jamesgrogantech/nuaire-mrxbox-eco2/hardware/case/preview.png

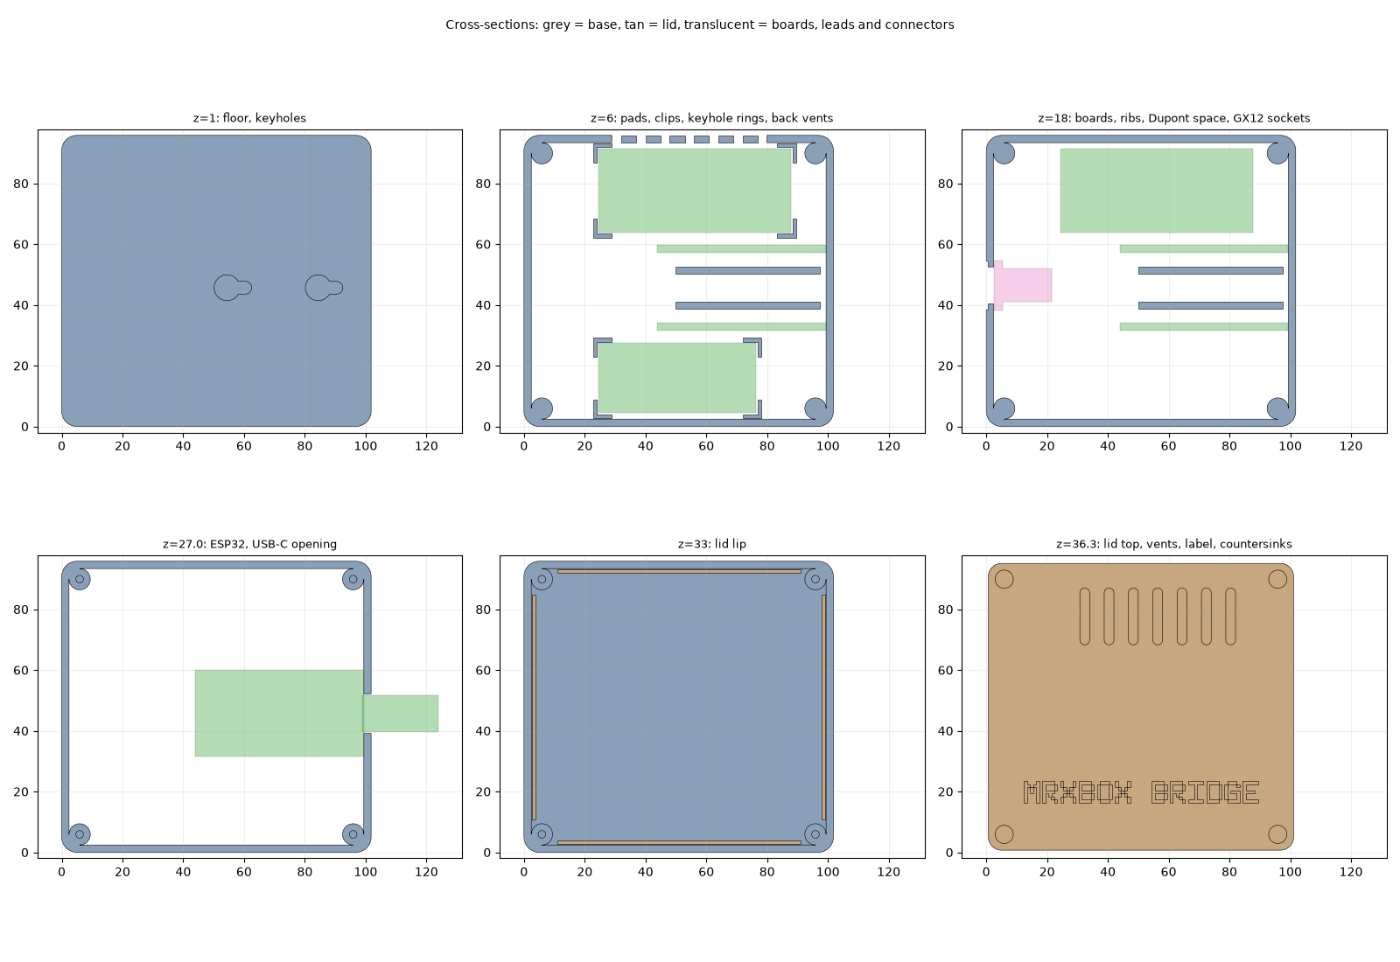
hardware/case/preview.png
