jamesgrogantech/nuaire-mrxbox-eco2/hardware/case/renders/1-closed.png

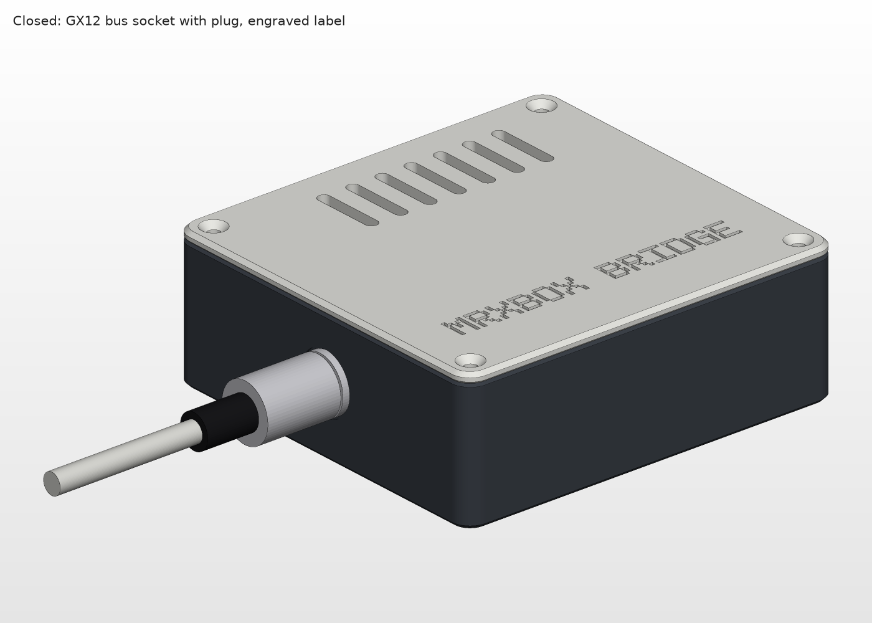
hardware/case/renders/1-closed.png
