jamesgrogantech/nuaire-mrxbox-eco2/hardware/case/renders/3-open.png

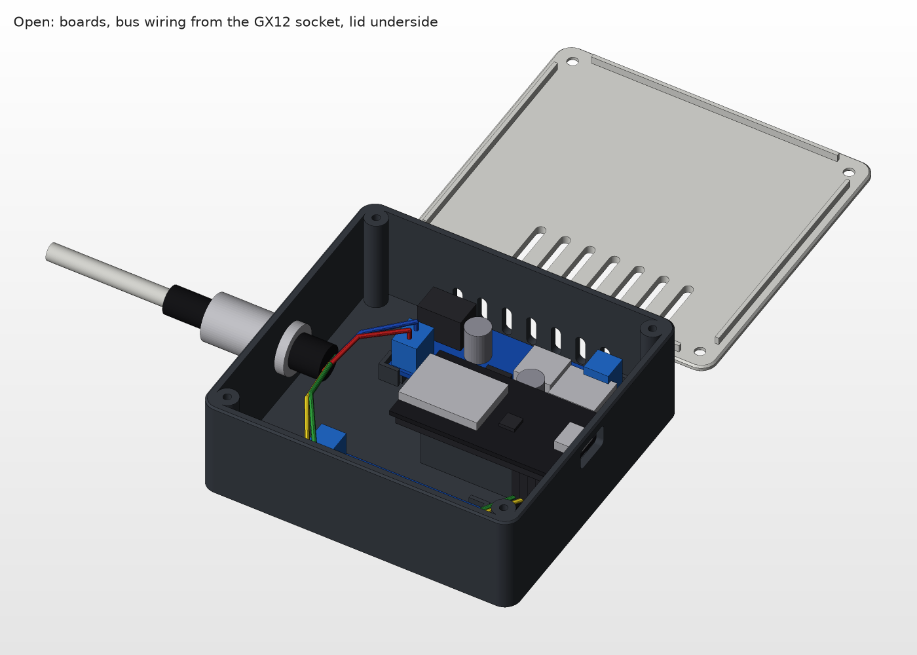
hardware/case/renders/3-open.png
