jamesgrogantech/nuaire-mrxbox-eco2/hardware/case/renders/5-bottom.png

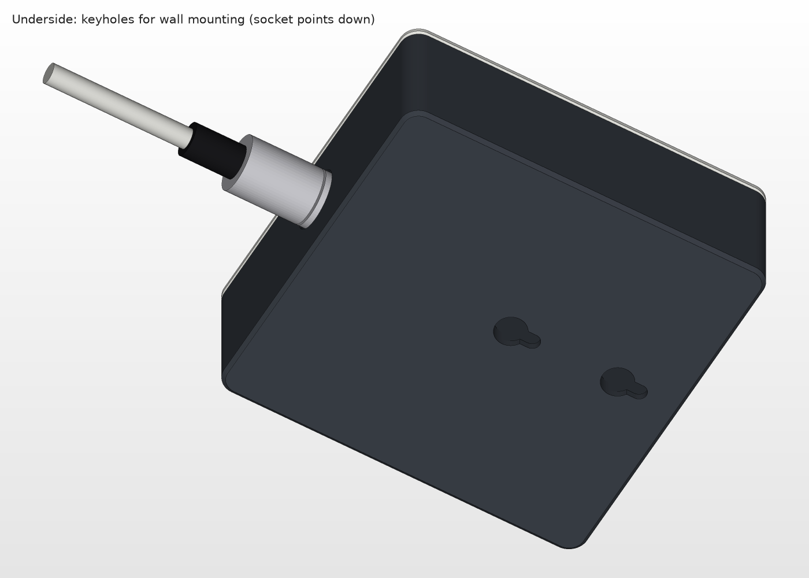
hardware/case/renders/5-bottom.png
