jamesgrogantech/nuaire-mrxbox-eco2/hardware/case/renders/6-sockets.png

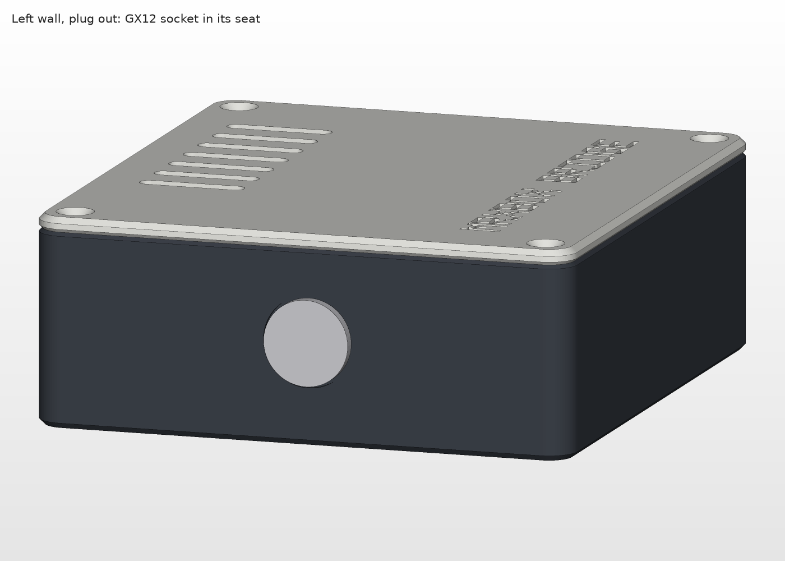
hardware/case/renders/6-sockets.png
