jamesgrogantech/nuaire-mrxbox-eco2/hardware/case/base.stl

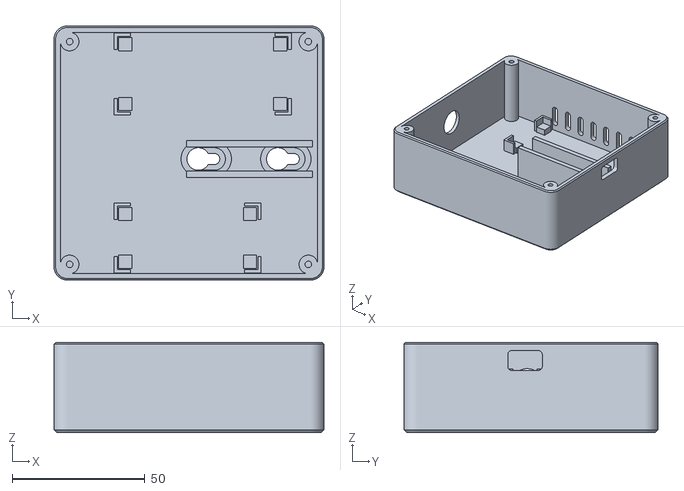
[picture p6: CAD file, 2026-11-08]
hardware/case/base.stl
101.8 x 95.8 x 34.0
