jamesgrogantech/nuaire-mrxbox-eco2/docs/wiring-deploy.html

Nuaire MRXBOX ECO2 · Home Assistant · read-only deploy

# MRXBOX HA Deploy Wiring

Permanent install: powered from the unit's own 12 V via a buck converter, reading the bus at 1200 baud over WiFi to Home Assistant. No laptop, no USB.

Set the buck output to 5.0 V with a meter BEFORE wiring it to the Pico. Trim-pot bucks ship at random voltages; VSYS tolerates max 5.5 V, and 12 V straight in destroys the Pico.

One 4-pin connector powers and feeds the Pico: 12 V through the buck (set to 5 V) into VSYS, A/B into the MAX485 whose RO drives GP5. Everything shares one ground. DE+RE tied low = physically receive-only. The Pico reads at 1200 8N1 and publishes over WiFi — no USB in service.

## Connections

Wire | From | To | Note
12V | MVHR 12V pin | Buck IN+ | The pin we kept capped until now
5V | Buck OUT+ | Pico VSYS (pin 39) | ⚠️ set buck to 5.0V first; add a Schottky in series if USB may also be plugged in
GND | MVHR GND | Buck IN−/OUT−, MAX485 GND, Pico GND (pin 38) | One common ground for everything
A | MVHR A | MAX485 A | If no data: swap A/B (dongle needed the opposite order)
B | MVHR B | MAX485 B
Data | MAX485 RO | Pico GP5 (pin 7) | UART1 RX, 1200 8N1
3V3 | Pico 3V3 OUT (pin 36) | MAX485 VCC | ⚠️ pin 36, never pin 37 (3V3_EN)
Jumper | MAX485 DE+/RE | GND | Receive-only — cannot transmit
— | MAX485 DI | nothing | Unused (read-only)

## Bring-up order

- Set the buck to 5.0 V on the bench (12V or any source in, meter on the output, turn the trim-pot) before anything connects to the Pico.
- Wire grounds first, then A/B to the MAX485, then RO/3V3, then last the buck 5 V to VSYS.
- Power the unit; the Pico boots, joins WiFi, reads the bus. No USB needed — but you can still plug USB for firmware updates (that's why the Schottky matters if both power sources meet).
- If the MAX485 module has a 120 Ω terminator and reception looks noisy on an already-terminated bus, lift it.

Read-only by design — DE+RE grounded means the Pico physically cannot drive the bus. Firmware reads 1200 8N1 on GP5, bit-reverses data bytes, and publishes humidity / temperature / fan state to Home Assistant. Companion to the bench diagram in docs/wiring.html and the field map in docs/protocol.md.
