jamesgrogantech/nuaire-mrxbox-eco2/docs/wiring.html

Nuaire MRXBOX ECO2 · Phase 1 · receive-only

# MRXBOX Sniffer Wiring

Pico W + RS485 module tapped onto the MVHR display connector for bus sniffing. Five wires now, one dashed option for later.

Two rules before anything touches the unit: run the RS485 module at 3.3 V (RP2040 pins are not 5 V-tolerant), and identify all four MVHR pins with the meter before connecting a single wire — the 12 V pin stays unconnected in this phase.

Receive-only tap: the RS485 pair lands on the module's A/B, the module's RO feeds the Pico's UART1 RX on GP5, and DE + R̄Ē tied to ground keep the driver permanently off so nothing can transmit onto the bus. Solid wires are this build; the dashed 12 V → buck → VSYS run is the later self-powered option.

## Connections

Wire | From | To | Note
A | MVHR pin (idles higher) | Module A | Confirm with meter: higher idle voltage of the two data lines
B | MVHR pin (idles lower) | Module B | If first captures are garbage at every baud, swap A/B
GND | MVHR 0 V pin | Module GND + Pico pin 38 | One common ground — the only connection shared with the unit besides A/B
Data | Module RO | Pico GP5 (pin 7) | UART1 RX — matches RX_PIN = 5 in the sniffer firmware
Power | Pico 3V3 (pin 36) | Module VCC | 3.3 V only. A 5 V-fed module puts ~5 V on RO and can kill the RP2040 pin
Jumper | Module DE + R̄Ē | Module GND | Driver off, receiver on — the tap physically cannot transmit
— | Module DI | nothing | Unused until the write-back phase
12 V | MVHR 12 V pin | nothing (later: buck → VSYS pin 39) | Cap it off for now. Never to VSYS directly — 5.5 V max

## Identifying the four MVHR pins

Pin | Meter signature (DC to GND)
GND | 0 V, rock steady. Find first: probe pin pairs until one reads a steady 12 V — the lower pin of that pair is GND
12 V | Steady ~12 V, no flicker
A | Idle ~1.5–3.3 V, the higher of the two data lines; flickers with traffic
B | Idle lower than A (often 0.5–1.5 V); flickers with traffic

- Getting GND right matters most — tying the unit's 12 V rail to Pico ground shorts it through USB and can damage the unit's PSU.
- Both data lines steady at ~0 V usually means the bus is just quiet — wait 30 s+, sensors poll infrequently.
- Cheap modules often carry a 120 Ω termination resistor. If reception looks corrupted on a bus that already has termination, remove it. Keep the tap stub under ~30 cm.

Companion to docs/hardware.md in the nuaire repo — that file holds the safety procedure (isolate the unit before opening) and the full pin-identification walkthrough. Firmware expects GP5 / UART1 RX; capture with nc <pico-ip> 9000.
