jamesgrogantech/nuaire-mrxbox-eco2/(commit log)

2026-09-13 Reverse-engineer Nuaire MRXBOX ECO2 bus; read-only Home Assistant integration
    Decoded the MVHR's display-connector bus from scratch and built a Pico W +
    MAX485 bridge that publishes to Home Assistant over MQTT.
    Protocol (docs/protocol.md):
    - RS485, 1200 baud 8N1, data bytes MSB-first (bit-reversed vs UART)
    - ~0.7s broadcast of 9 gap-separated messages
    - Humidity: msg 3B byte1 bit-reversed -> RH% (stimulus-confirmed)
    - Fan/boost: msg 21 byte2 bit 0x02 (stimulus-confirmed)
    - Temperature: candidate values constant + unresponsive to stimulus -> not a
    real reading; retracted
    Firmware:
    - firmware/ha/ha_read.py: read @1200 8N1 on GP5, publish humidity+boost with
    HA MQTT auto-disco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
    [analyze.py, baudfind.py, bittiming.py, capture_frame.py, decode1200.py, diff_frames.py, ha_read.py, main.py]
2026-09-13 Add long-term frame-byte logging (both HA-native and CSV) to decode more fields
    Firmware: publish all 16 candidate frame bytes (bit-reversed) as one
    nuaire/raw CSV topic every 15s, alongside the existing humidity/boost. Built
    via an additive gap-split assembler; the anchored humidity/boost decode is
    unchanged.
    Method A (HA-native): docs/ha-diagnostics.yaml - 16 diagnostic MQTT template
    sensors parsing nuaire/raw; correlate in HA History vs Met.no outdoor temp.
    Method B (offline): tools/log_raw.sh (mosquitto_sub -> timestamped CSV) and
    tools/analyze_longterm.py (stdlib; per-byte variance/trend + correlation with
    time-of-day and open-meteo outdoor temp).
    docs/longterm-logging.md documents t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
    [analyze_longterm.py, ha_read.py]
2026-09-13 firmware: self-heal CYW43 zombie WiFi; HA-native raw logging via MQTT discovery
    Pico bridge was dying every 2-6 min and staying dead until manual repower.
    Root cause: the CYW43 WiFi stack goes "zombie" - w.isconnected() keeps
    returning True and holds the IP, but no traffic flows and socket sends don't
    raise, so the firmware published into a dead link forever with no exception
    and no reset. A plain watchdog doesn't help (the loop isn't hung, it's fed).
    ha_read.py:
    - Liveness probe: after each publish, c.ping() + c.wait_msg() with a 3s socket
    timeout, requiring a broker PINGRESP round-trip. A zombie/dead link times out
    -> exception -> machine.reset() after 2 consecutive fails (~30s), whic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
    [ha_read.py, publish_raw_discovery.py]
2026-09-14 Prepare for public release: license, contributor docs, secret scrub
    - Add MIT LICENSE (2026 James Grogan)
    - Rewrite README as a public, hardware-agnostic guide with a prominent mains
    safety warning, the confirmed protocol summary, and a "use your own hardware"
    section (Pico W reference; ESP32/ESPHome and USB-RS485 dongle documented)
    - Add CONTRIBUTING.md (receive-only safety, 2-capture confirmation rule,
    capture naming, code conventions, how to report a unit/hardware)
    - Add GitHub unit-report issue template and PR checklist template
    - Scrub the MQTT password and personal LAN IPs from tracked files
    (tools/log_raw.sh now requires args; docs use placeholder IPs)
    - ha_read.py: static IP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
    [ha_read.py, publish_raw_discovery.py, secrets.example.py]
2026-09-15 Document temps as poll-only; add full-frame capture + dumper
    Full-frame capture (every byte of every broadcast message) shows the unit's
    autonomous broadcast is exactly the 9 known messages, with every non-mapped
    byte = 0xFE padding. Combined with 50h of logging (nothing tracks the outdoor
    temperature swing) and the MRXBOX-VSC manual (unit has Extract + Supply temp
    sensors, display shows Outside + Indoor temp), this confirms the temperatures
    are NOT broadcast — the display obtains them by polling the unit. Reading them
    requires MITM-sniffing a real VSC to capture the poll + response.
    - docs/protocol.md: add "Temperatures are POLL-ONLY" (CONFIRMED) and the
    "85 = fan/mode" hypothesis; cor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
2026-09-15 Add VSC MITM guide to capture the polled temperatures
    For anyone who has the MRXBOX-VSC display: the temperatures are polled, not
    broadcast, so a bus capture with a real VSC present is what's needed to decode
    them. Adds a step-by-step guide using a Waveshare ESP32-S3-RS485-CAN passive
    tap (verified RS485 pins: TX GPIO17, RX GPIO18, DE GPIO21; termination jumper
    NC), plus a MicroPython capture tool that flags non-broadcast (poll/response)
    frames, and how to confirm temp fields with a warm-the-extract stimulus.
    - docs/vsc-mitm.md: the guide (passive tap + optional in-line MITM)
    - firmware/esp32-s3/vsc_capture.py: the capture tool
    - README + roadmap: link it, call-to-action for VSC owners
    Co-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
2026-09-16 Solve the XOR checksum, document 7-bit framing, add command-format research
    Checksum: the last byte of every broadcast message is an XOR check. XOR of
    all bytes in a message (header + data + check) equals 0xAB in the raw UART
    view (0xD5 bit-reversed). Verified on 36/36 messages across the two 1200-baud
    captures and the HA long-term frame; tools/checksum_verify.py reproduces it.
    The bytes previously described as "mirror"/"integrity copy" (21_3, 3B_3,
    85_6) are this checksum, not data.
    Framing: in the unit's MSB-first bit order every header has bit 7 set and
    every payload/check byte has bit 7 clear (7-bit payload, 0x7F = padding).
    Both Phase 3 preconditions (framing + checksum) are now met; a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
2026-11-05 Cross-check against karwantes/Nuaire-MVHR; record bus connector pitch
    protocol.md: add an upstream cross-check section. karwantes/Nuaire-MVHR
    (dc6fb54) answers the unit's 88/8A/AE/C5 controller slots to control it
    without a VSC, tested on one ECO4. Our captures match its framing,
    checksum and no-VSC slot defaults byte for byte. Recorded as HYPOTHESIS
    for our ECO2: temperatures likely broadcast in A1 (raw 85), and RH may be
    inverted (byte ^ 0x7F), which conflicts with our shower test and needs a
    reference hygrometer.
    hardware.md: the base connector is a shrouded single-row 4-pin header at
    2.54 mm pitch (four Dupont housings fit side by side), pin order red,
    yellow, green, blue per Nuaire's l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
2026-11-05 Add printable case for the RS485 bridge
    Parametric two-part case (hardware/case/case.py, manifold3d) for an
    ESP32-WROOM-32, XY-485 auto-direction module and HW-688 buck, with a GX12
    4-pin socket for the bus cable, USB-C opening for flashing, vents,
    keyholes for wall mounting and an engraved lid label. The generator
    checks that boards, connector, Dupont leads, USB plug and screw heads
    clear the case and lid. render.py makes 3D preview renders.
    Board sizes are from seller listings and the case is not yet printed:
    measure the parts and edit PARAMETERS before printing.
2026-11-08 Adopt upstream humidity/temperature decodes; record VSC emulation test
    Humidity is now rev(b) ^ 0x7F and the extract/intake temperatures come
    from the 85 message (raw >> 1, signed 7-bit), per karwantes/Nuaire-MVHR.
    Both are HYPOTHESIS on this ECO2 until a stimulus test confirms them.
    ha_read.py checks each message's XOR checksum and publishes the two
    temperatures; the analysis tools label the new columns.
    protocol.md: add the replay plan for VSC emulation with the karwantes
    bridge and the first result (2026-11-08, one run, HYPOTHESIS): replies
    to 88/8A/AE/C5 sent with none late, and speed 3 changed the fans audibly.
    Claude-Session: ht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
2026-11-08 Add ESPHome firmware for VSC emulation on the ESP32 bridge
    nuaire_vsc external component ports the karwantes vsc-serial-bridge
    emulation core (dc6fb54): a 25 us gptimer ISR and a bus edge ISR
    bit-bang replies to the unit's 88/8A/AE/C5 polls, and frames 84/A1/DC
    are decoded for faults, temperatures and humidity. Settings, run/filter
    hours and the speed-3/night/holiday/bypass timers persist in NVS.
    mrxbox.yaml exposes these as Home Assistant entities over the encrypted
    native API, with password-protected OTA. This replaces the Arduino
    firmware's web UI, telnet and unauthenticated OTA.
    Fixes found on the device:
    - re-include esp_driver_gptimer, which ESPHome's IDF build leaves out
    - template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
2026-11-08 Credit karwantes/Nuaire-MVHR for the decodes and VSC emulation
    README credits karwantes for the VSC decode, the humidity/temperature
    encodings and the emulation approach, and lists firmware/esphome/. The
    nuaire_vsc component is a port of karwantes' code, which has no published
    license, so it is excluded from the repo's MIT grant.
    Claude-Session: https://claude.ai/code/session_01FyouYTBRhL6DKZpKAh2wKn
2026-11-09 Cover the ESPHome port under MIT; record karwantes' feedback
    karwantes/Nuaire-MVHR is now MIT licensed. Keep their copyright notice
    in components/nuaire_vsc/LICENSE-karwantes and drop the README wording
    that excluded the port from the repo's MIT license.
    protocol.md: add karwantes' 2026-11-09 feedback from their ECO4. RH
    rev(b) ^ 0x7F tracks a shower test there, the heater fault bit reads
    faulted with no heater fitted, cooler and test-required are unverified,
    and their wire-order names map to ours (A1/DC/84 = 85/3B/21, D5 = AB).
    All stay HYPOTHESIS on our ECO2 until reproduced here.
    Claude-Session: https://claude.ai/code/session_01Fyo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
